gmaltezos/Transfer-of-materials-in-FMS-using-Drones/Solidworks_Files/Connection_Assembly.SLDASM

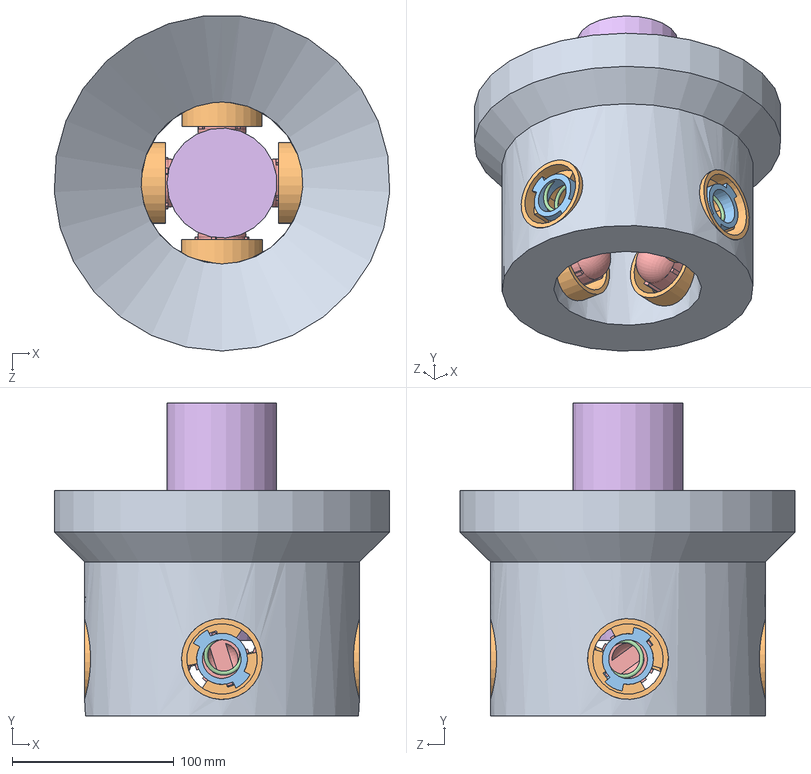
[picture p50: CAD file, 2022-02-12]
Solidworks_Files/Connection_Assembly.SLDASM
207.3 x 193.2 x 207.0 mm
Target
Latch_Shell x 4
Blocking_Component x 4
Spring x 4
Sliding_Cylinder x 4
Probe
