gmaltezos/Transfer-of-materials-in-FMS-using-Drones/Solidworks_Files/Latch_Assembly.SLDASM

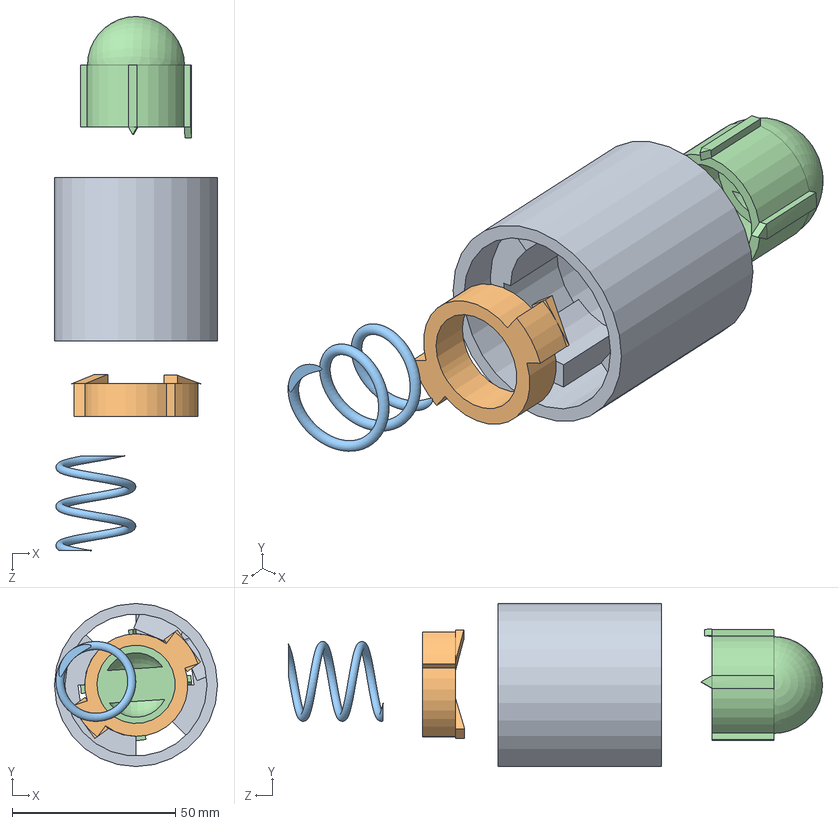
[picture p51: CAD file, 2022-02-12]
Solidworks_Files/Latch_Assembly.SLDASM
50.0 x 50.0 x 163.7 mm
Latch_Shell
Blocking_Component
Spring
Sliding_Cylinder
