gmaltezos/Transfer-of-materials-in-FMS-using-Drones/Solidworks_Files/Target.SLDPRT

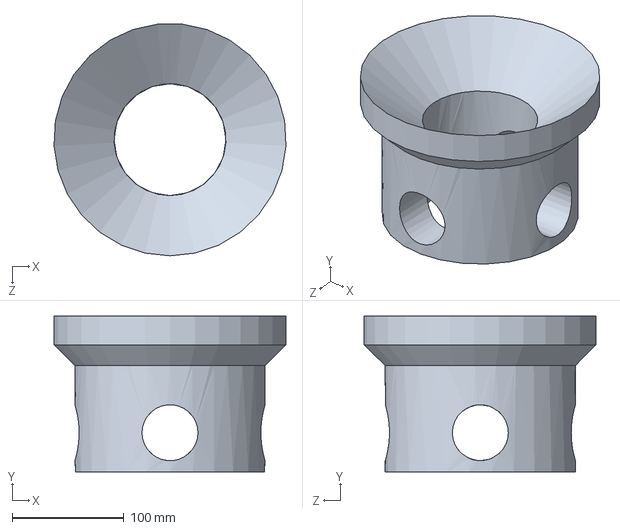
[picture p52: CAD file, 2022-02-12]
Solidworks_Files/Target.SLDPRT
207.3 x 139.4 x 207.0 mm
