gmaltezos/Transfer-of-materials-in-FMS-using-Drones/Solidworks_Files/Latch_Shell.SLDPRT

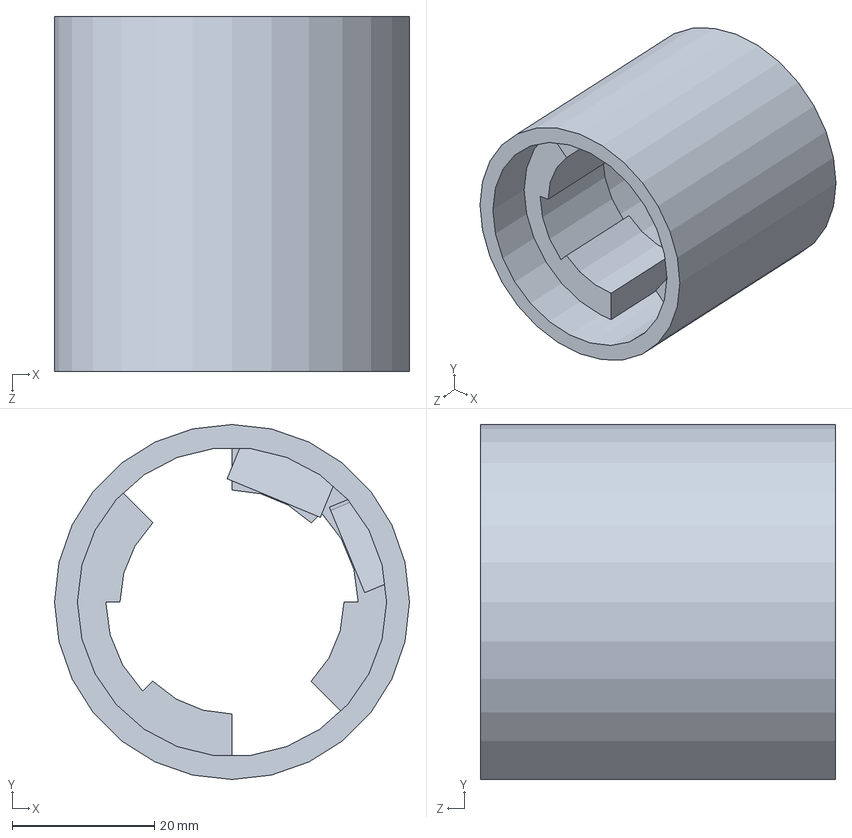
[picture p53: CAD file, 2022-02-12]
Solidworks_Files/Latch_Shell.SLDPRT
50.0 x 50.0 x 50.0 mm
