gmaltezos/Transfer-of-materials-in-FMS-using-Drones/Solidworks_Files/Spring.SLDPRT

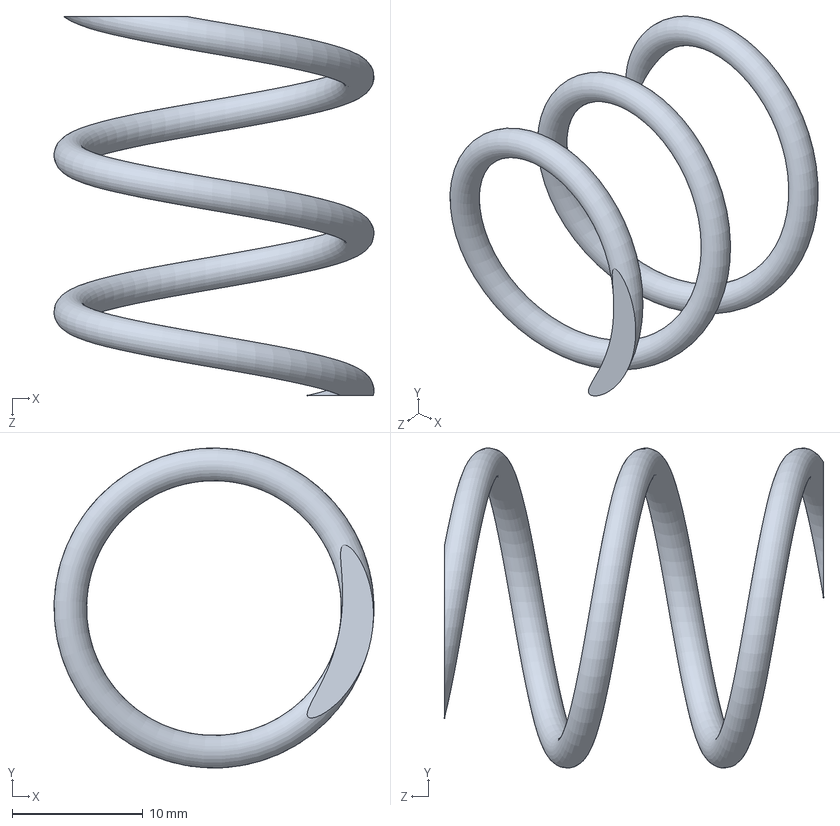
[picture p54: CAD file, 2022-02-12]
Solidworks_Files/Spring.SLDPRT
24.5 x 24.5 x 29.0 mm
