gmaltezos/Transfer-of-materials-in-FMS-using-Drones/Solidworks_Files/Sliding_Cylinder.SLDPRT

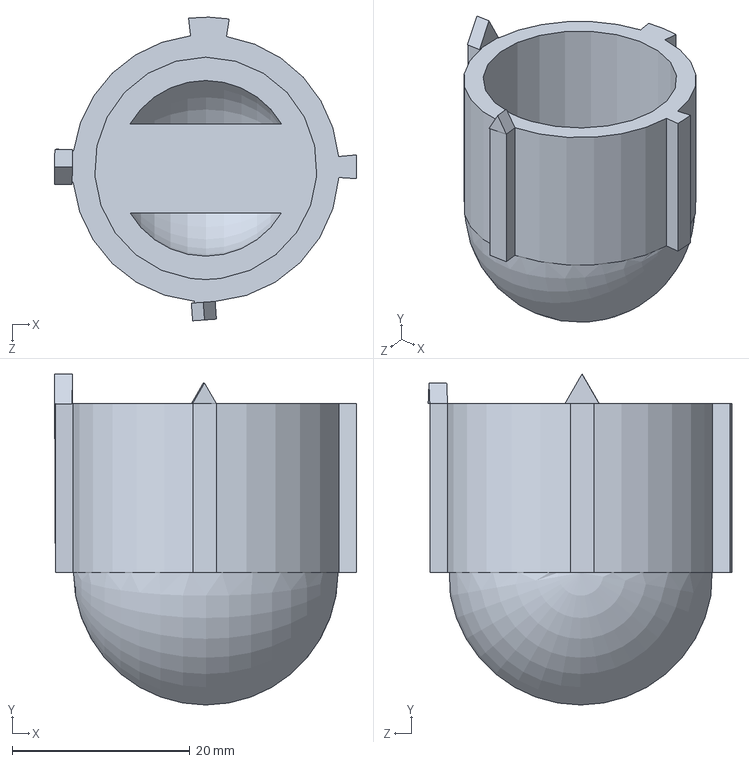
[picture p55: CAD file, 2022-02-12]
Solidworks_Files/Sliding_Cylinder.SLDPRT
34.0 x 37.2 x 34.1 mm
