gmaltezos/Transfer-of-materials-in-FMS-using-Drones/Solidworks_Files/Abstract_Quad.SLDPRT

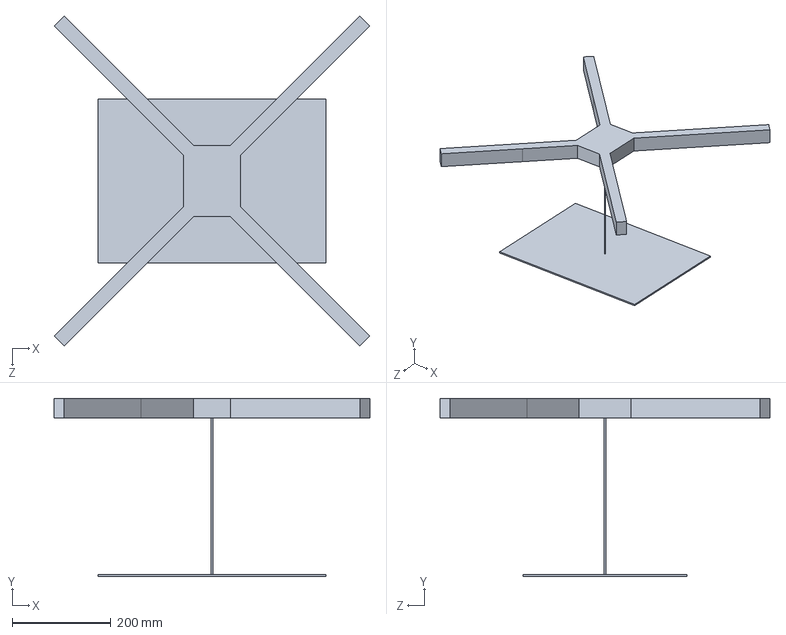
[picture p56: CAD file, 2022-02-12]
Solidworks_Files/Abstract_Quad.SLDPRT
638.7 x 361.0 x 667.6 mm
