gmaltezos/Transfer-of-materials-in-FMS-using-Drones/Solidworks_Files/Blocking_Component.SLDPRT

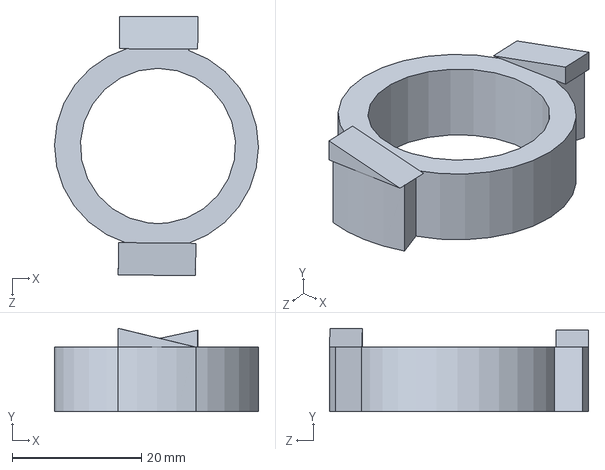
[picture p57: CAD file, 2022-02-12]
Solidworks_Files/Blocking_Component.SLDPRT
31.5 x 12.9 x 40.1 mm
