gmaltezos/Transfer-of-materials-in-FMS-using-Drones/Solidworks_Files/Probe.SLDPRT

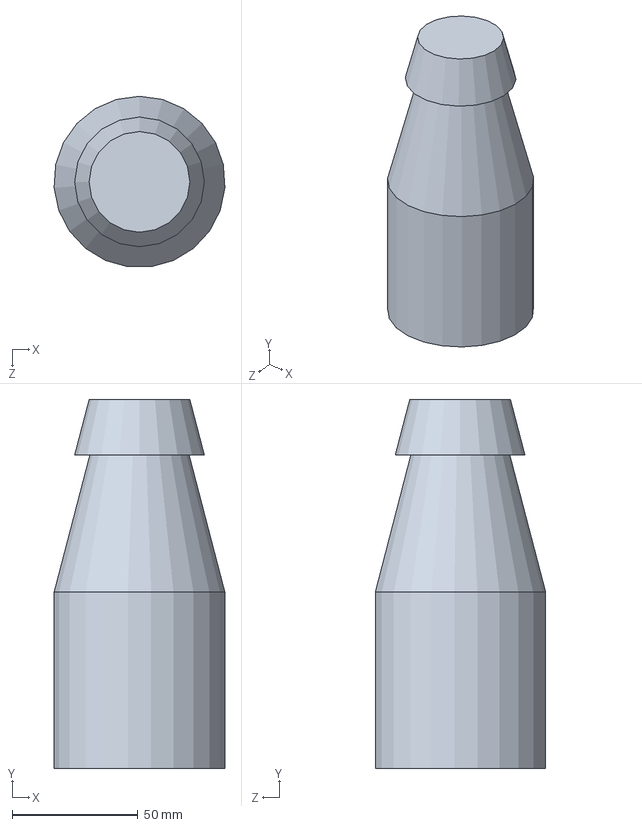
[picture p58: CAD file, 2022-02-12]
Solidworks_Files/Probe.SLDPRT
67.8 x 146.5 x 67.7 mm
